dkramnik/ee242a/ee242a-lab4-amp-bom.xlsx

BOM Line | Qty/PCBA | Value | Device | Package | Refdes | MFR | MPN | Distributor | Distributor P/N | Distributor Description | Comment
1 | 1 | BFG403W | Transistor | SOT343R | Q1 | NXP | BFG403W | EE242A Lab | - | - | Obsolete
2 | 2 | CAP CER 0.1UF 25V X7R 0603 10% | Capacitor | C0603 | C12, C17 | Samsung | CL10B104KA8WPNC | Digikey | 1276-6717-1-ND | CAP CER 0.1UF 25V X7R 0603 | Ordered Nov 5, 2018
3 | 1 | CAP CER 10000PF 25V X7R 0603 10% | Capacitor | C0603 | C14 | Samsung | CL10B103KA8NNNC | Digikey | 1276-1132-1-ND | CAP CER 10000PF 25V X7R 0603 | Ordered Nov 5, 2019
4 | 3 | CAP CER 100PF C0G 0402 | Capacitor | C0402 | C4, C10, C11 | Kemet | C0402C101J3GACTU | Digikey | 399-1022-1-ND | CAP CER 100PF 25V C0G/NP0 0402 | Ordered Nov 5, 2020
5 | 1 | CAP CER 10000PF X7R 0402 | Capacitor | C0402 | C1 | American Technical Ceramics | 520L103KT16T | Digikey | 1284-1540-1-ND | CAP CER 10000PF 16V X7R 0402 | Ordered Nov 5, 2021
6 | 3 | CAP CER 10PF C0G 0402 | Capacitor | C0402 | C5, C8, C9 | Kemet | CBR04C100J1GAC | Digikey | 399-8804-1-ND | CAP CER 10PF 100V C0G/NP0 0402 | In Kemet Cap Kit
7 | 2 | CAP CER 10UF 10V X7R 0805 | Capacitor | C0805 | C13, C16 | Kemet | C0805C106M8RACTU | Digikey | 399-7413-1-ND | CAP CER 10UF 10V X7R 0805 | Ordered Nov 5, 2018
8 | 1 | CAP CER 15PF C0G 0603 | Capacitor | C0603 | C15 | Wurth Electronics Inc. | 885012006052 | Digikey | 732-7794-1-ND | CAP CER 15PF 50V C0G/NP0 0603 | Ordered Nov 5, 2019
9 | 1 | CAP CER 1000PF C0G 0402 | Capacitor | C0402 | C7 | Kemet | C0402C102J3GACTU | Digikey | 399-7751-1-ND | CAP CER 1000PF 25V C0G/NP0 0402 | Ordered Nov 5, 2020
10 | 1 | CAP CER 2.4PF C0G 0402 | Capacitor | C0402 | C2 | Kemet | CBR04C249B5GAC | Digikey | 399-16068-1-ND | CAP CER RF 2.4PF 50V +/-0.1 PF C | Ordered Nov 5, 2021
11 | 1 | CAP CER 2.7PF C0G 0402 | Capacitor | C0402 | C6 | Kemet | CBR04C279B1GAC | Digikey | 399-8592-1-ND | CAP CER 2.7PF 100V C0G/NP0 0402 | In Kemet Cap Kit
12 | 1 | CAP CER 8.2PF C0G 0402 | Capacitor | C0402 | C3 | Kemet | CBR04C829C1GAC | Digikey | CBR04C829C1GAC-ND | CAP CER 8.2PF 100V NP0 0402 | In Kemet Cap Kit
13 | 1 | IND 20NH 0402 | Inductor | R0402 | L1 | Murata | LQW15AN20NG80D | Digikey | 490-14710-1-ND | FIXED IND 20NH 800MA 186 MOHM | Ordered Nov 5, 2018
14 | 1 | IND 24NH 0402 | Inductor | R0402 | L2 | Murata | LQW15AN24NG8ZD | Digikey | 490-15367-1-ND | FIXED IND 24NH 770MA 212 MOHM | Ordered Nov 5, 2019
15 | 1 | SMA SMT | Connector | Custom | X1, X2, X3 | Molex, LLC | 732511150 | Digikey | WM5534-ND | CONN SMA RCPT STR 50OHM EDGE MNT | Ordered Nov 5, 2020
16 | 1 | RES SMD 49.9 OHM 1% 0805 | Resistor | R0805 | R6 | Stackpole | RMCF0805FT49R9 | Digikey | RMCF0805FT49R9CT-ND | RES 49.9 OHM 1% 1/8W 0805 | Ordered Nov 5, 2021
17 | 1 | RES SMD 1.4K OHM 1% 1/10W 0402 | Resistor | R0402 | R2 | Panasonic | ERJ-2RKF1401X | Digikey | P1.40KLCT-ND | RES SMD 1.4K OHM 1% 1/10W 0402 | Ordered Nov 5, 2022
18 | 2 | RES SMD 1.6K OHM 1% 1/10W 0402 | Resistor | R0402 | R1, R3 | Panasonic | ERJ-2RKF1601X | Digikey | P1.60KLCT-ND | RES SMD 1.6K OHM 1% 1/10W 0402 | Ordered Nov 5, 2023
19 | 1 | RES SMD 30.1K OHM 1% 1/10W 0603 | Resistor | R0603 | R5 | Panasonic | ERJ-3EKF3012V | Digikey | P30.1KHCT-ND | RES SMD 30.1K OHM 1% 1/10W 0603 | Ordered Nov 5, 2024
20 | 1 | RES SMD 51K OHM 1% 1/10W 0603 | Resistor | R0603 | R4 | Panasonic | ERJ-3EKF5102V | Digikey | P51.0KHCT-ND | RES SMD 51K OHM 1% 1/10W 0603 | Ordered Nov 5, 2025
21 | 1 | TPS73001 | Integrated Circuit | SOT23-6L | IC1 | Texas Instruments | TPS73001DBVR | Digikey | 296-27055-1-ND | IC REG LIN POS ADJ 200MA SOT23-6 | Ordered Nov 5, 2026
22 | 1 | VDD | Test Point | Custom | TP1 | Keystone | 5000 | Digikey | 36-5000-ND | PC TEST POINT MINIATURE RED | Ordered Nov 5, 2027
23 | 1 | GND | Test Point | Custom | TP2 | Keystone | 5001 | Digikey | 36-5001-ND | PC TEST POINT MINIATURE BLACK | Ordered Nov 5, 2028
24 | 4 | MOUNT-PAD-ROUND3.0 | DNP | DNP | H1, H2, H3, H4 | - | - | - | - | - | DNP
