dkramnik/ee242a/ee242a-lab4-amp2.brd

## EAGLE design ee242a-lab4-amp2.brd (2019-01-04)

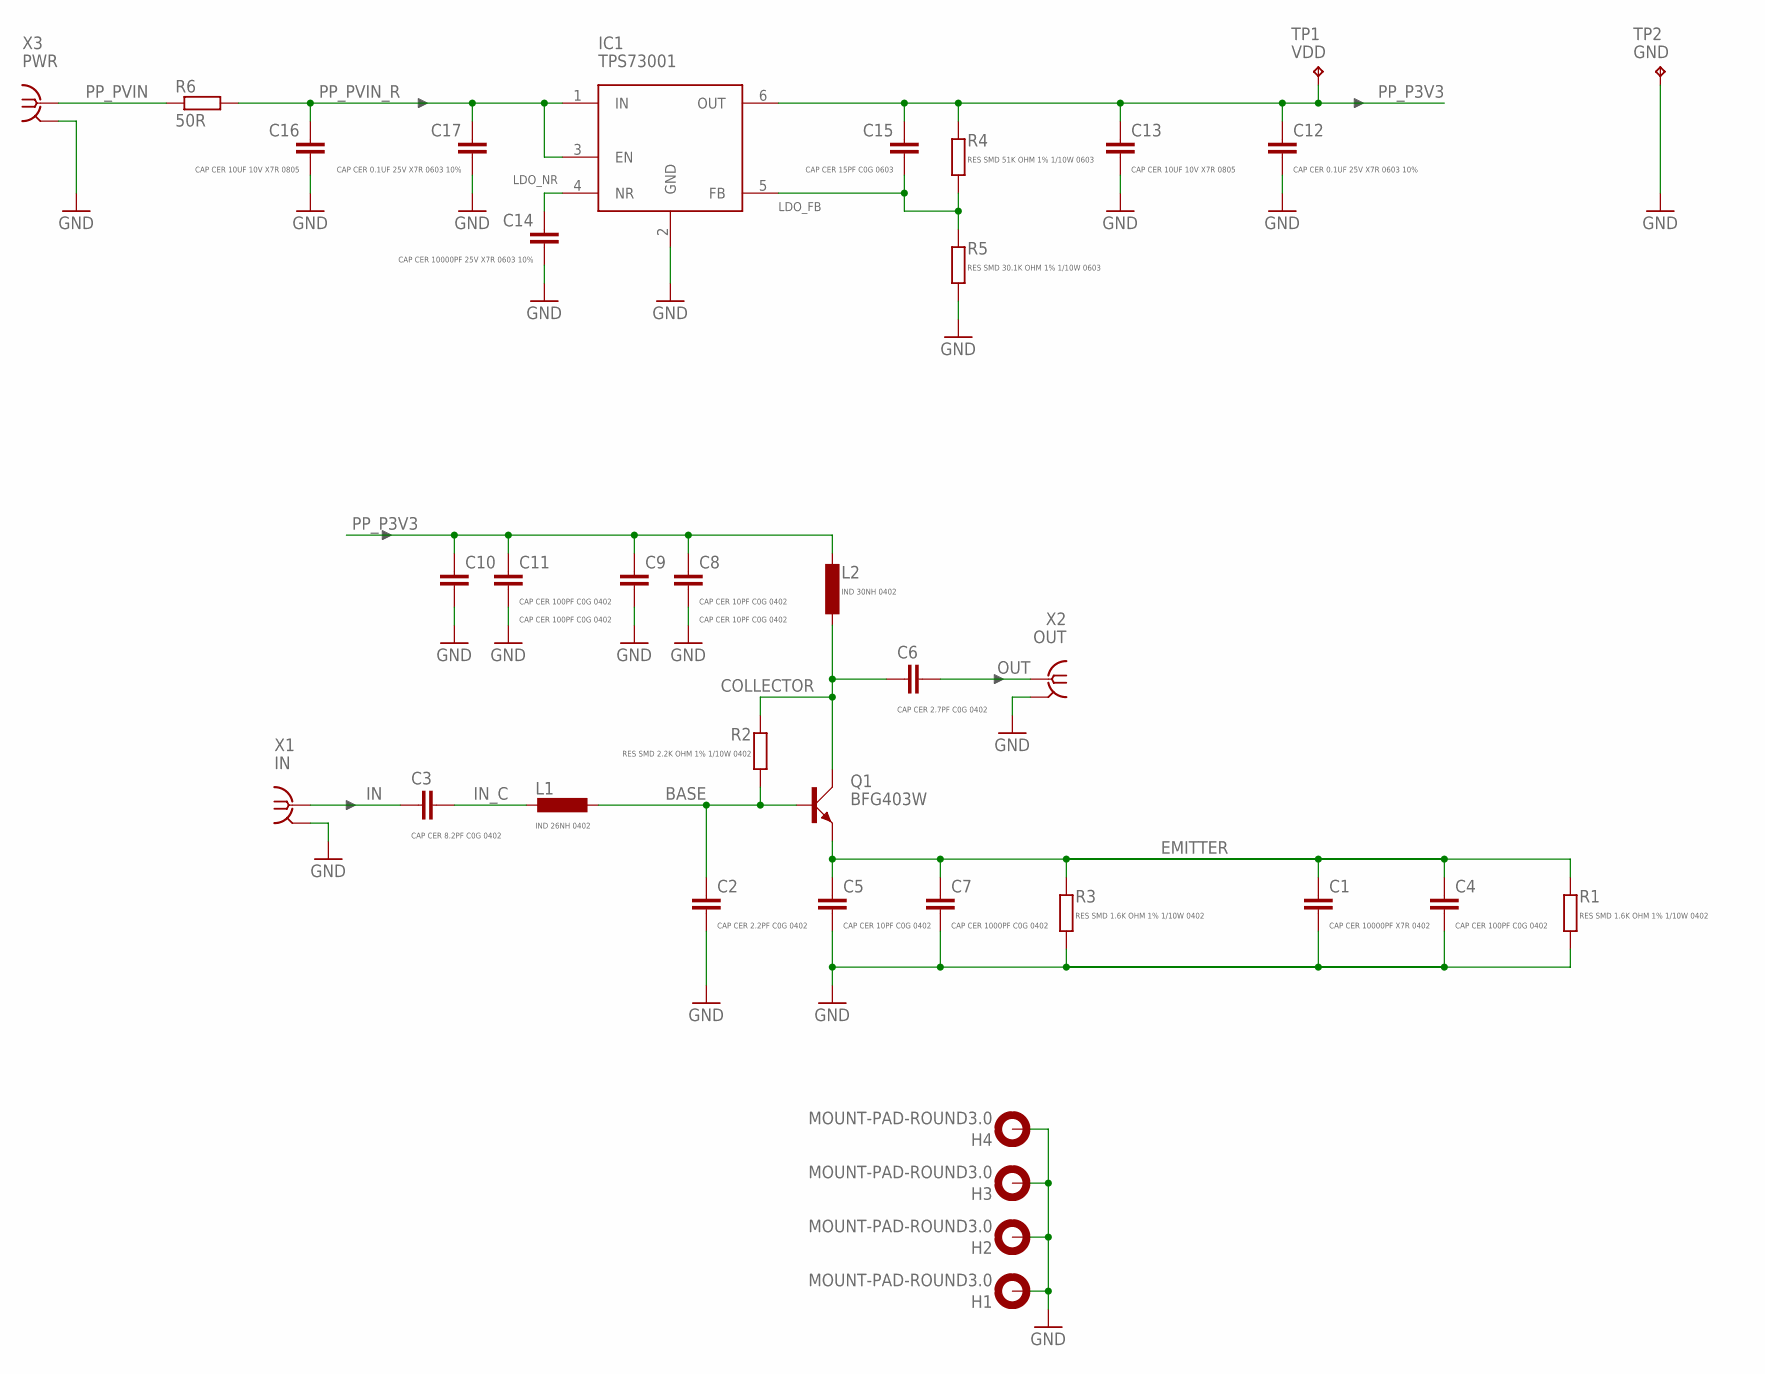
[picture p1: schematic ee242a-lab4-amp2.sch]

Parts:
C1: CAP CER 10000PF X7R 0402; C0402
C2: CAP CER 2.2PF C0G 0402; C0402
C3: CAP CER 8.2PF C0G 0402; C0402
C4, C10, C11: CAP CER 100PF C0G 0402; C0402
C5, C8, C9: CAP CER 10PF C0G 0402; C0402
C6: CAP CER 2.7PF C0G 0402; C0402
C7: CAP CER 1000PF C0G 0402; C0402
C12, C17: CAP CER 0.1UF 25V X7R 0603 10%; C0603
C13, C16: CAP CER 10UF 10V X7R 0805; C0805
C14: CAP CER 10000PF 25V X7R 0603 10%; C0603
C15: CAP CER 15PF C0G 0603; C0603
H1, H2, H3, H4: MOUNT-PAD-ROUND3.0; 3,0-PAD
IC1: TPS73001; SOT23-6L
L1: IND 26NH 0402; R0402
L2: IND 30NH 0402; R0402
Q1: BFG403W; SOT343R
R1, R3: RES SMD 1.6K OHM 1% 1/10W 0402; R0402
R2: RES SMD 2.2K OHM 1% 1/10W 0402; R0402
R4: RES SMD 51K OHM 1% 1/10W 0603; R0603
R5: RES SMD 30.1K OHM 1% 1/10W 0603; R0603
R6: 50R; R0805
TP1: VDD; KEYSTONE_5000_MINIATURE
TP2: GND; KEYSTONE_5000_MINIATURE
X1: IN; J502-ND-142-0701-881/886
X2: OUT; J502-ND-142-0701-881/886
X3: PWR; J502-ND-142-0701-881/886

Connections:
BASE: C2.1, L1.2, Q1.2 (B), R2.2
COLLECTOR: C6.1, L2.2, Q1.4 (C), R2.1
EMITTER: C1.1, C4.1, C5.1, C7.1, Q1.1 (E), Q1.3 (E), R1.1, R3.1
GND: C1.2, C2.2, C4.2, C5.2, C7.2, C8.2, C9.2, C10.2, C11.2, C12.2, C13.2, C14.2, C16.2, C17.2, H1.B3,0, H2.B3,0, H3.B3,0, H4.B3,0, IC1.2 (GND), R1.2, R3.2, R5.2, TP2.P$1, X1.G@1 (GND), X1.G@2 (GND), X1.G@3 (GND), X1.G@4 (GND), X2.G@1 (GND), X2.G@2 (GND), X2.G@3 (GND), X2.G@4 (GND), X3.G@1 (GND), X3.G@2 (GND), X3.G@3 (GND), X3.G@4 (GND)
IN: C3.1, X1.1
IN_C: C3.2, L1.1
LDO_FB: C15.2, IC1.5 (FB), R4.1, R5.1
LDO_NR: C14.1, IC1.4 (NR)
OUT: C6.2, X2.1
PP_P3V3: C8.1, C9.1, C10.1, C11.1, C12.1, C13.1, C15.1, IC1.6 (OUT), L2.1, R4.2, TP1.P$1
PP_PVIN: R6.1, X3.1
PP_PVIN_R: C16.1, C17.1, IC1.1 (IN), IC1.3 (EN), R6.2

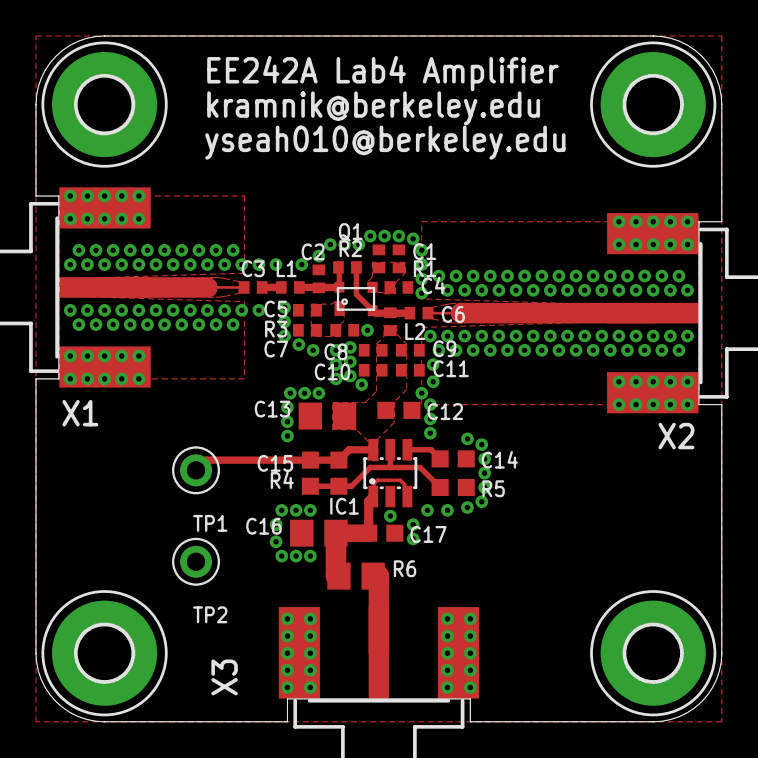
[picture p2: board ee242a-lab4-amp2.brd from above]

Board: 2 copper layers, 38.1 x 38.1 mm, 36 parts (0 on the bottom side), 12 nets.
