dkramnik/ee242a/(commit log)

2018-11-02 Added standard gitignore for eagle PCBA
2018-11-02 created schematic
    [ee242a-lab4-amp.sch]
2018-11-06 PCBA sendout 1
    [ee242a-lab4-amp.brd, ee242a-lab4-amp.sch]
2018-11-06 Created and ordered BOM
    [ee242a-lab4-amp-bom-ulp-export.csv, ee242a-lab4-amp-bom.xlsx, ee242a-lab4-amp.brd, ee242a-lab4-amp.sch]
2018-11-15 Updated component values
    [ee242a-lab4-amp -values2.sch, ee242a-lab4-amp-values2.brd]
2018-12-09 Started oscillator board
    [ee242a-lab4-amp-values2.sch, ee242a-lab6-amp-osc.brd, ee242a-lab6-amp-osc.sch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]
